derfang/FPGA-Board-with--400-IOs/README.md

> **Note:** Just read `FPGA_Project.pdf` and `FPGA project Report.pdf` for details.
