derfang/FPGA-Board-with--400-IOs/FPGA project Report.pdf

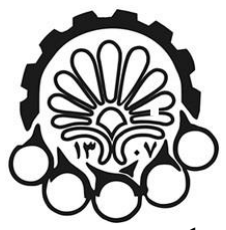
[picture p1: figure]

## دانشگاه صنعتي امیرکبیر

### )پلیتکنیک تهران( دانشكده مهندسی برق

# گزارش پروژه درس مدارهای منطقی برنامه پذیر

### دکتر شریعتمدار

## نگارش

### دانیال فتح پور 9923059

### عرفان قصری 9923061

زمستان 1402

# فهرست محتوا

# بخش اول:

# طراحی کلی مدار:

### سیستم را به طور کلی به دو بخش برد اصلی )برد دارای FPGA، Ethernet و قابلیت اتصال به برد های IO )و 10 عدد برد IO( قابلیت اتصال به 10 ورودی دیجیتال، 10 خروجی دیجیتال، 10 ورودی آنالوگ، 10 خروجی آنالوگ و 422RS )تقسیم می کنیم که بلوک دیاگرام آن ها به صورت زیر است:

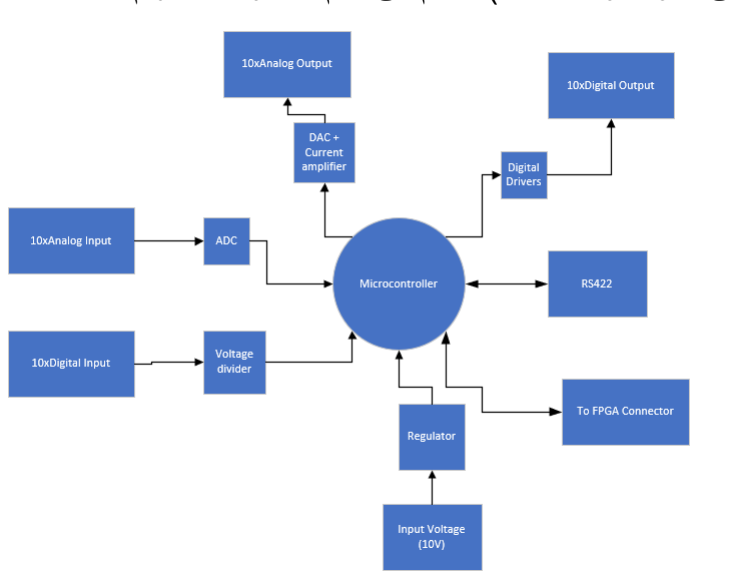
[picture p2: figure]
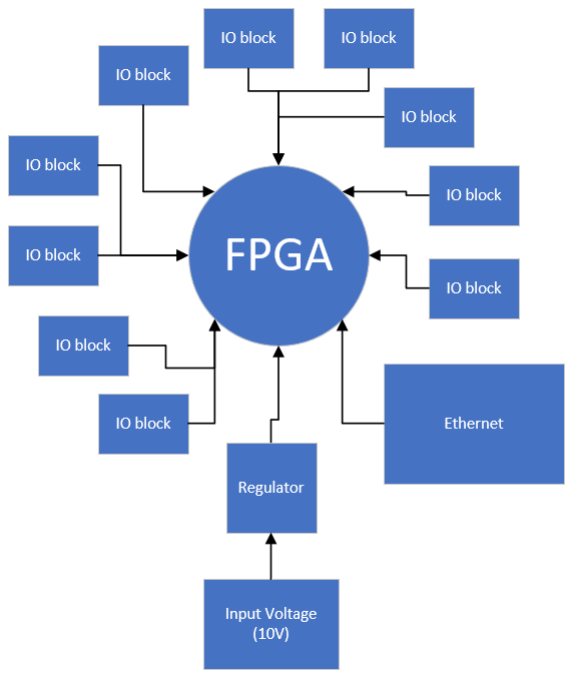
[picture p3: figure]

# انتخاب قطعات:

## انتخاب میکرو:

برای انتخاب میکرو مد نظر در هر Board IO بر اساس طرح کلی اولیه به برنامه cubeMX32STM مراجعه کرده و میکرو مد نظر را انتخاب می کنیم. در این جا میکرو 6RCT103F32STM انتخاب شد.در این جا خواسته ها عبارتند از: - 3 عدد SPI( یکی برای ارتباط با برد اصلی، یکی برای ADC و یکی برای DAC ) - تعداد مناسبی پین GPIO برای اتصال به بقیه قسمت ها

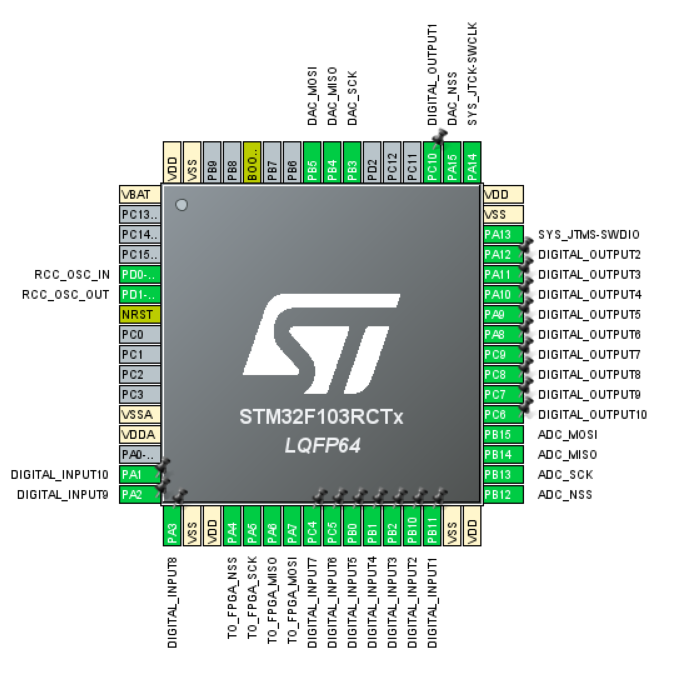
[picture p4: figure]

همانطور که مشخص است بر اساس طراحی اولیه باال تمامی خواسته های برد برطرف می شود.

## انتخاب تراشه ADC و DAC :

### ابتدا برای انتخاب تراشه ADC از طریق سایت شرکت Devices Analog اقدام می کنیم و و بر اساس نیاز های این برد تراشه 11311MAX را انتخاب می کنیم )حداقل 10 کانال داشته باشد و سطح ولتاژ 5± را تحمل کند .( که متوجه می شویم هم می تواند ADC و هم DAC باشد و جریان خروجی آن 25

میلی آمپر است که بنابراین نیاز است از تقویت کننده جریان )یک مدار پوش پول( استفاده کنیم.

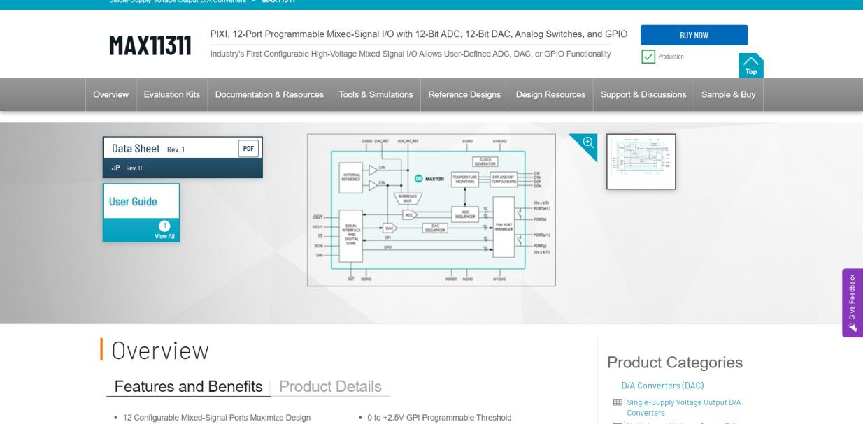
[picture p5: figure]

## انتخاب درایور دیجیتال:

برای اعمال ولتاژ های باالی 3.3ولت نیازمند درایور برای خروجی دیجیتال هستیم که ساده ترین آن ها یک ترانزیستور است که توان جریان دهی مناسبی داشته باشد و ابعاد کمی هم داشته باشد بر این اساس 817BC انتخاب می شود.

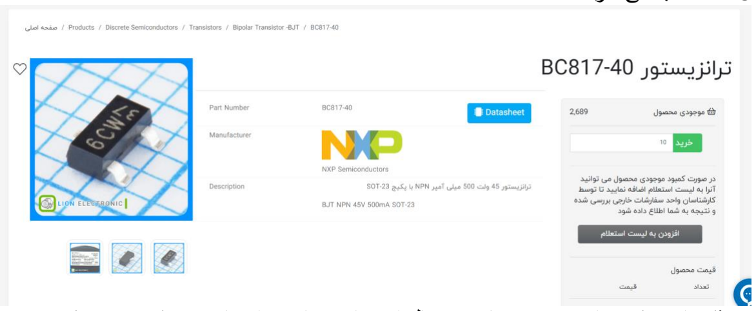
[picture p6: figure]

### الزم به ذکر است که برای ورودی های دیجیتال از تراشه خاصی استفاده نمی کنیم و به یک تقسیم

مقاومتی ساده بسنده می کنیم.

## انتخاب درایور 422RS:

### برای انتخاب این درایور از سایت instrument Texas کمک می گیریم و به تراشه 1400THVD می

رسیم.

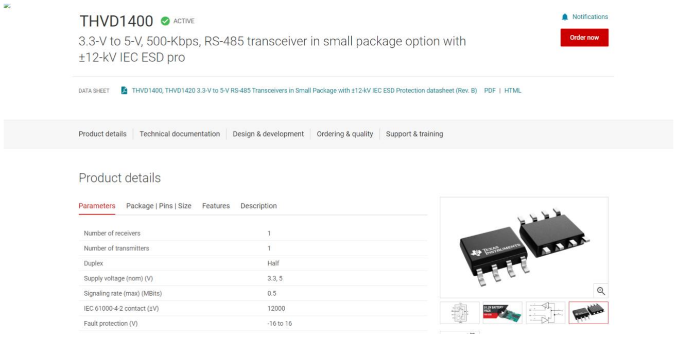
[picture p7: figure]

## انتخاب درایور Ethernet:

### برای انتخاب این تراشه از PCB اپن سورس OpenRex استفاده می کنیم و همان تراشه ای که در آنجا

استفاده شده را قرار می دهیم که تراشه RNXIA9031KSZ است.

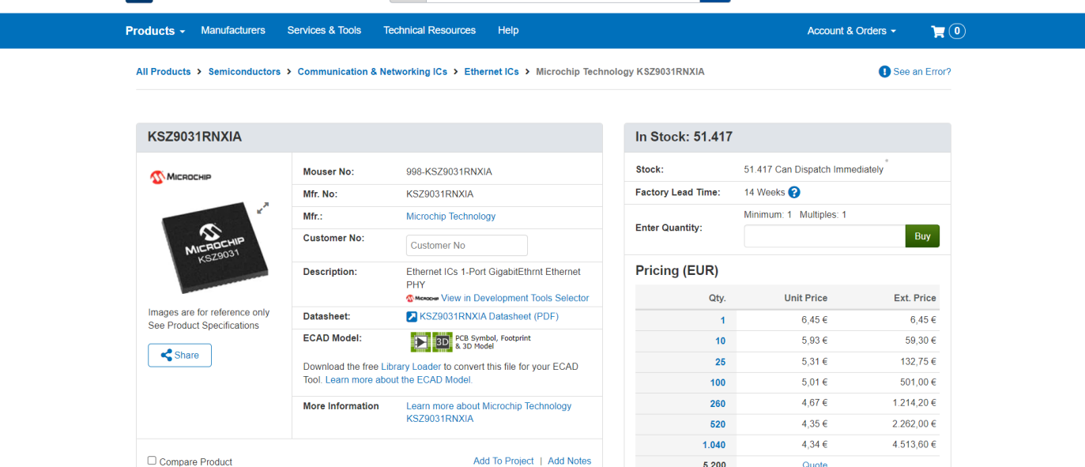
[picture p8: figure]

## انتخاب هسته اصلی:

برای انتخاب هسته اصلی از نرم افزار Vivado استفاده می کنیم و بر اساس خواسته های مسئله )10 عدد برد IO و یک عدد اترنت و 10 عدد ارتباط 422RS که در مجموع به حدود 100 عدد پایه نیازمندیم.( یک FPGA را انتخاب می کنیم. دلیل انتخاب تراشه FPGA به عنوان هسته اصلی سرعت آن و قابلیت موازی سازی آن است. نکته دیگر در مورد انتخاب FPGA ها این است که تا حد ممکن می

خواهیم از تراشه ای استفاده کنیم که برد آماده آن وجود داشته باشد تا بتوانیم مدار های جانبی تراشه

### مرکزی را به درستی طراحی کنیم. بنابر تمام نکات گفته شده به سری برد های PicoZed از شرکت

### Avnet می رسیم و برد 010Z7 را به دلیل اینکه 113 پایه IO دارد )خود تراشه دارای 225 پین است(

انتخاب می کنیم که دارای تراشه 225CLG010-1Z7XC است.

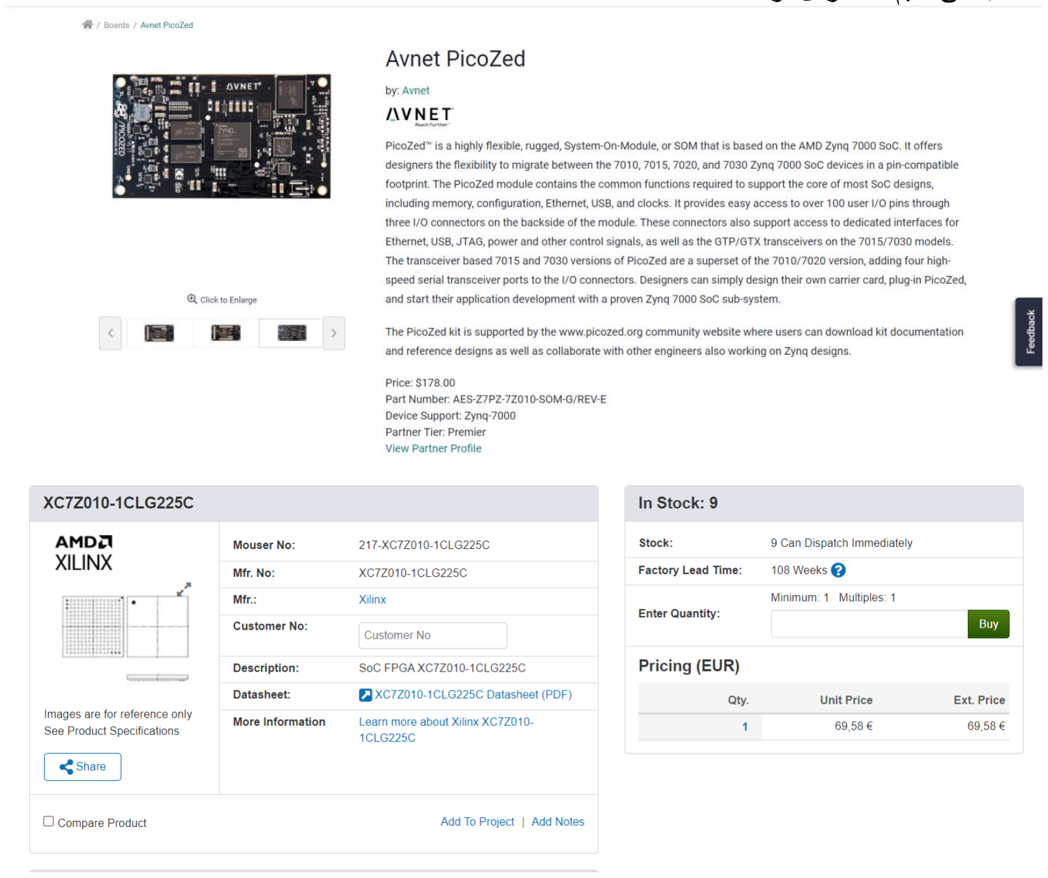
[picture p9: figure]

## انتخاب تغذیه:

بر اساس هسته اصلی، درایور اترنت، میکرو و تراشه آنالوگ به چند سطح ولتاژ DC نیازمندیم که برای

### هر کدام باید رگوالتور مربوطه را قرار دهیم. این تراشه رگوالتور ها را از سایت شرکت Texas instrument انتخاب می کنیم و در صورت توان از مدار های برد های اپن سورسی که در اختیار داریم

کمک می گیریم.
1V:

### TLV62130RGT

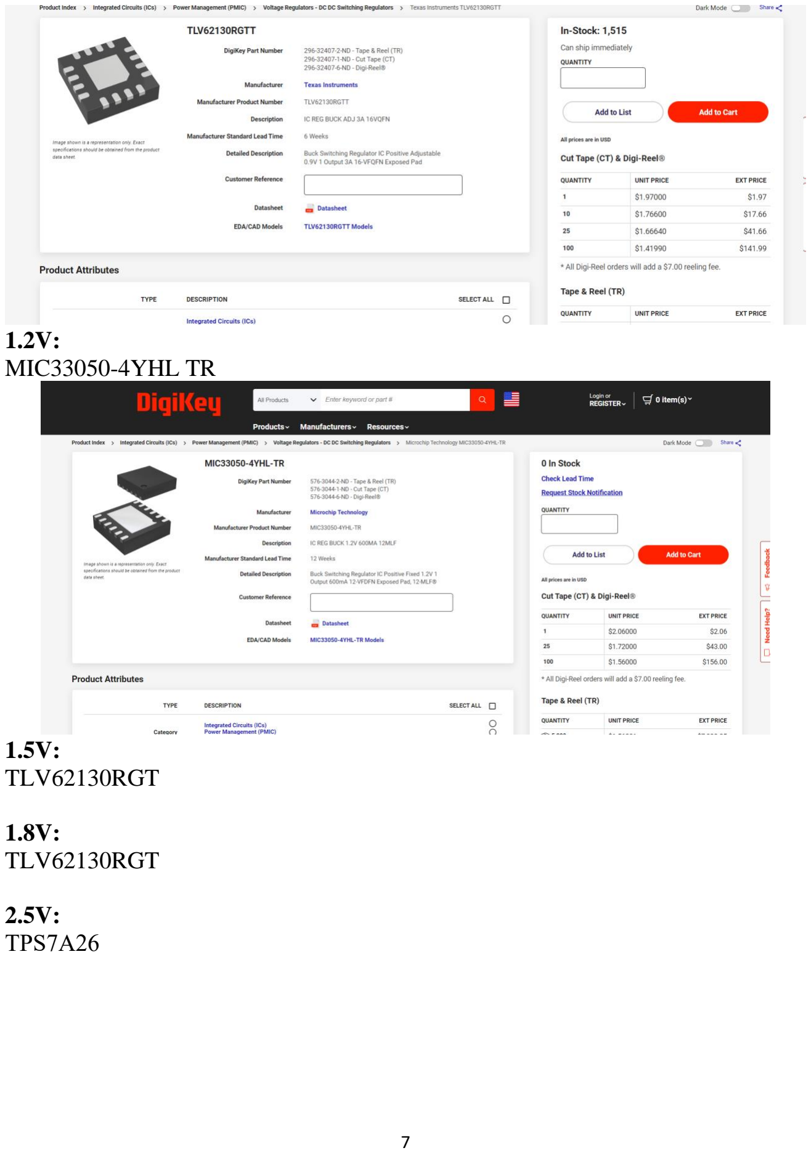
[picture p10: page 8]

1.2V:

### MIC33050-4YHL TR

1.5V:

### TLV62130RGT

1.8V:

### TLV62130RGT

2.5V:

### TPS7A26

3.3V:

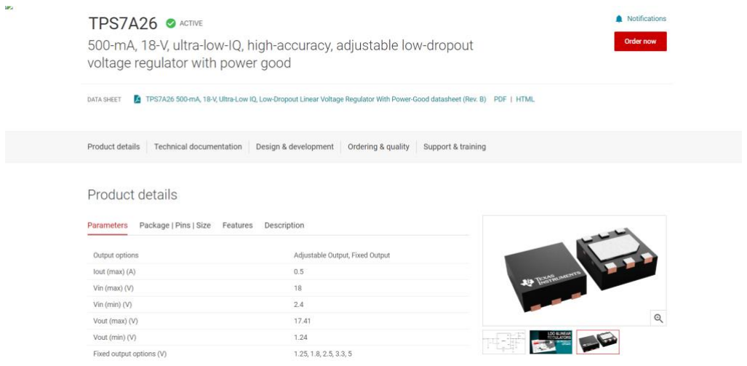
[picture p11: figure]

### ISL8024AIRTAJZ-T7A

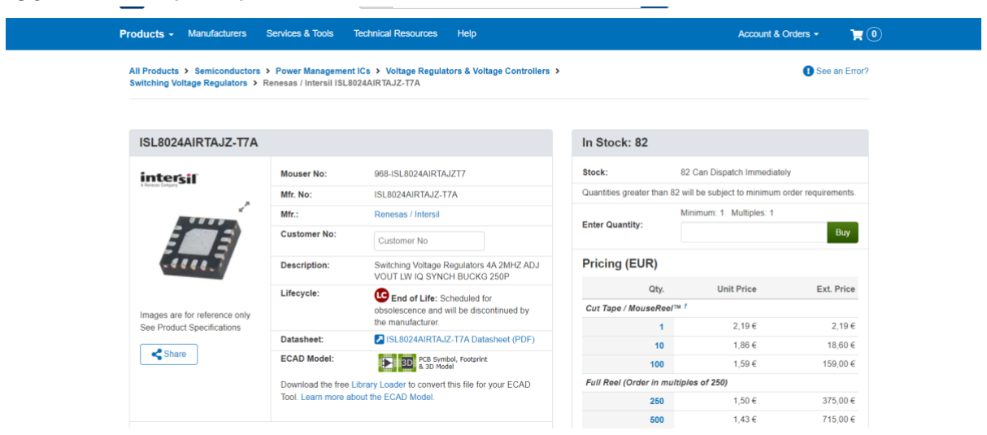
[picture p12: figure]

# ترسیم شماتیک:

## بخش توان:

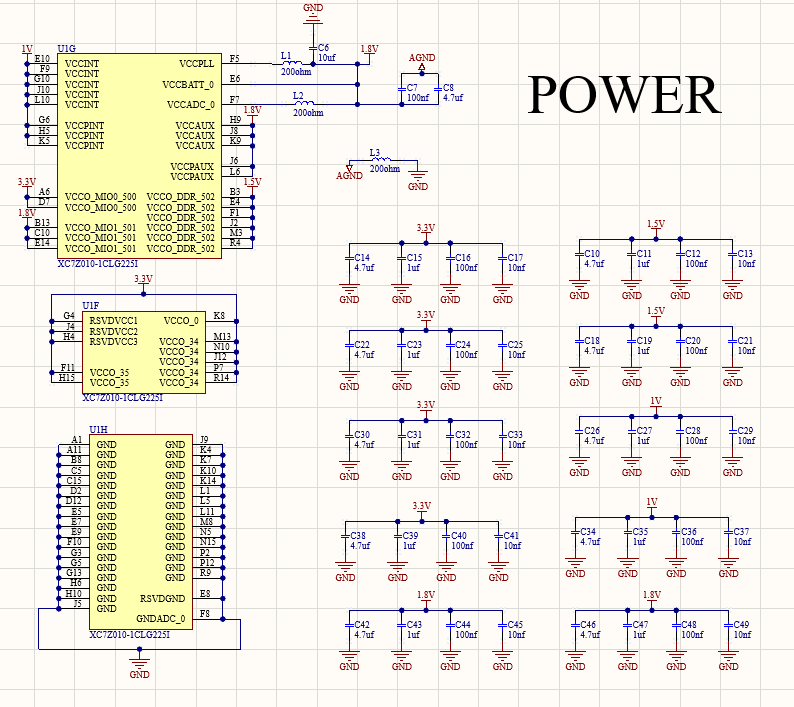
[picture p13: figure]

تصو یر شماره 1 : تامین توان تراشه اصلی

### در این بخش از نمونه های ارایه شده در فایل های تدریس یاری استفاده کردیم، خازن های با ظرفیت ها متفاوت برای حذف نویز در فرکانس های متفاوت به دلیل ض ریب کیفیت متفاوت خازن ها)ضرایب

کمتر برای خازن های بزرگ تر( به کار رفته اند.

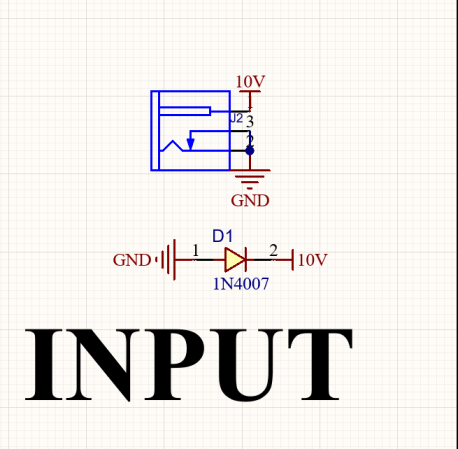
[picture p14: figure]

تصو یر شماره 2 : ورودی برق و دیود برای جلوگیری از آسیب دیدن مدار در صورت اتصال اشتباه قطب های مثبت و منفی

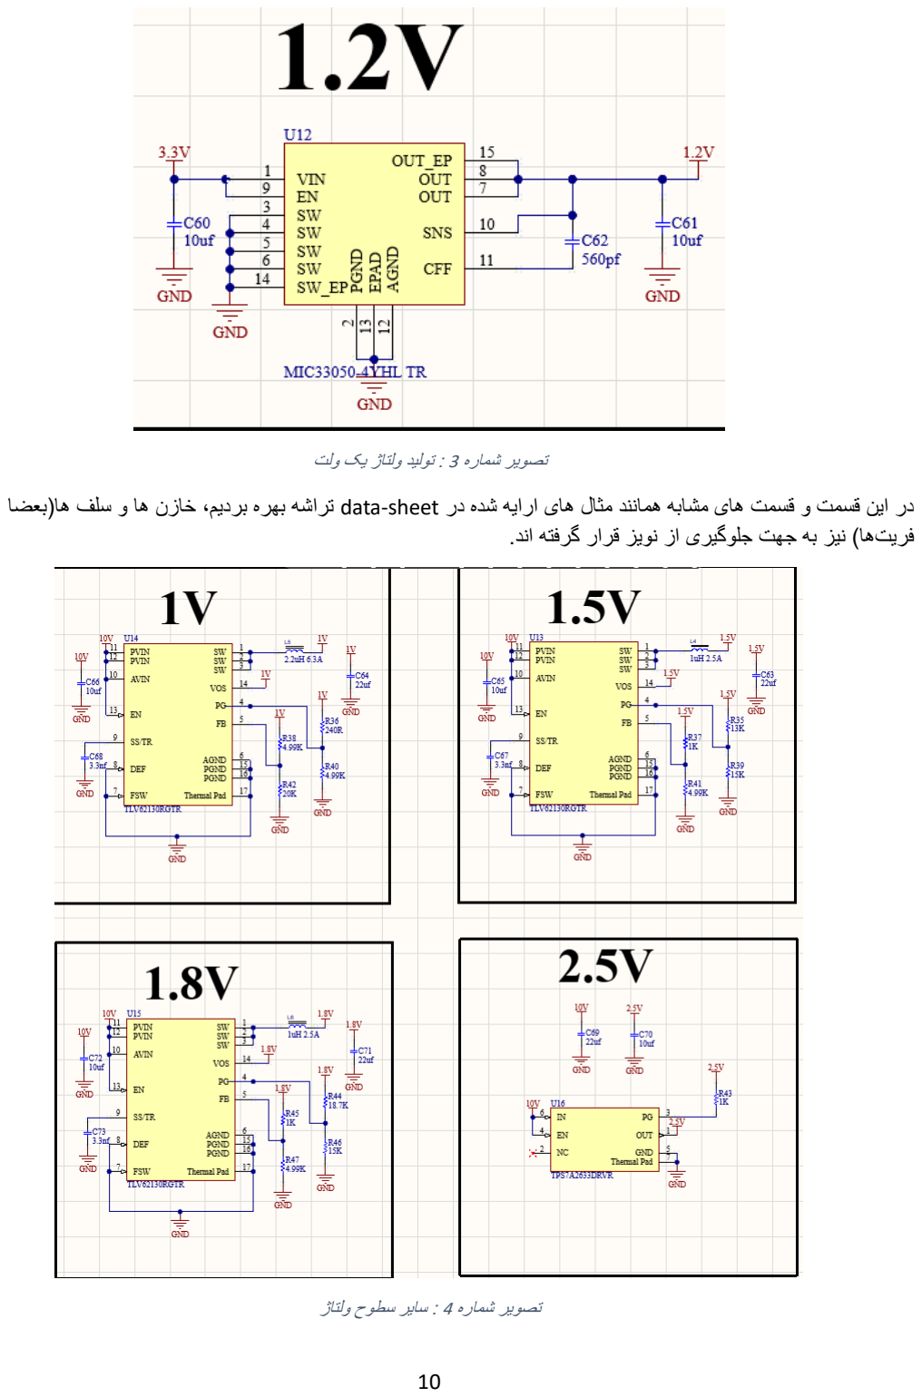
[picture p15: page 11]

تصو یر شماره 3 : تولید ولتاژ یک ولت

در این قسمت و قسمت های مشابه همانند مثال های ارایه شده در sheet-data تراشه بهره بردیم، خازن ها و سلف ها)ب عضا فریت ها( نیز به جهت جلوگیری از نویز قرار گرفته اند.

تصو یر شماره 4 : سایر سطوح ولتاژ

## بخش درایور ethernet:

برای پیکربندی درایور اترنت نی ز از مثال خود دیتاشیت استفاده کردیم و تنها پ ورت های دیتا را از یکطرف به تراشه و از طرف دیگر به پورت وصل کردیم:

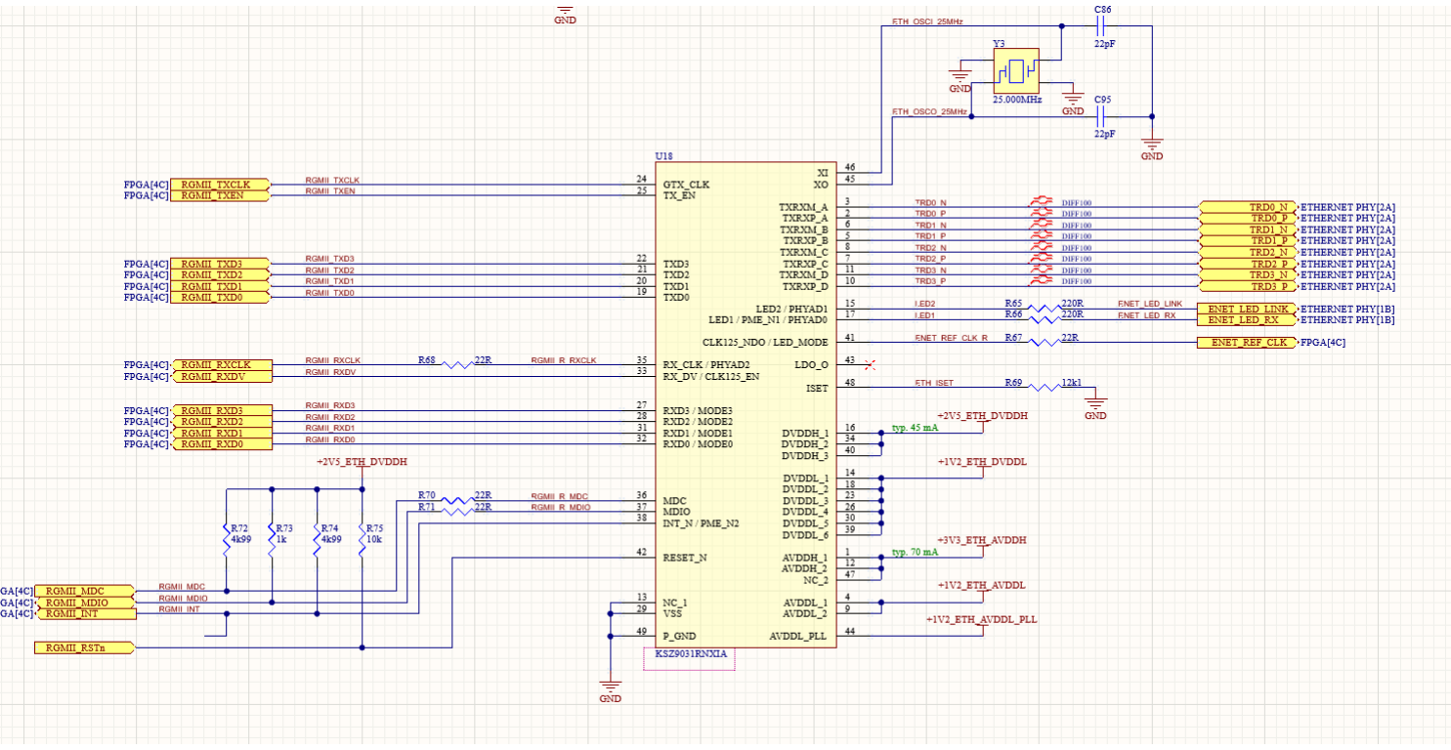
[picture p16: figure]

تصو یر شماره 5 : درایور اترنت به همراه نوسانگر مناسب

## بخش درایور 422RS:

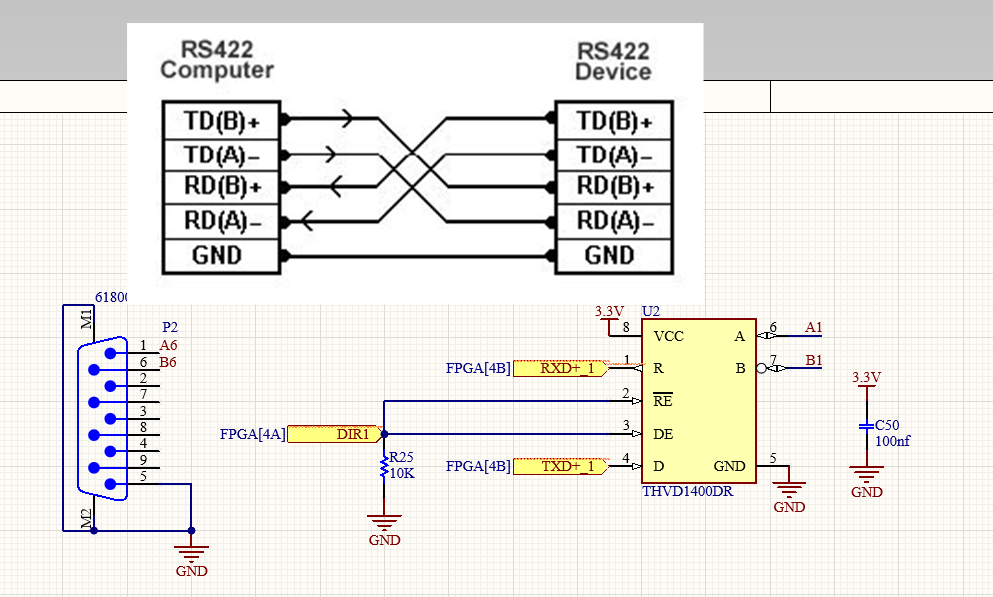
[picture p17: figure]

تصو یر شماره 6 : مجموعه درایور و پورت مادگی مناسب

## بخش راه انداز FPGA:

برای این بخ ش از یک حافظه کوچک استفاده کردیم:

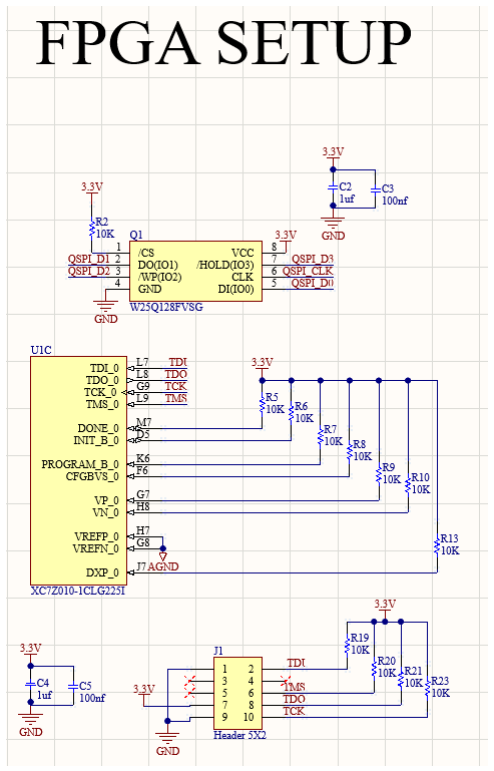
[picture p18: figure]

## بخش راه انداز FPGA:

به دلی ل شباهت بخش های مختلف تراشه اصلی تنها یک بخش از آنرا در تصویر زیر آوردم، برخی پورت ها از پیش تایین شده بودند که آنها را به مقادیر مناسبشان متصل کردیم، سایر پورت ها را با توجه به اطالعاتی که توسط Vivado درباره نوع پورت)برای مثال برخی پورت هاonly read بودند( تامین کرده بود به قسمت های مناسب)block-IO برای سیگنال های آنالوگ و دیجیتال که ب خش های ب عدی به آن میپردازم و درایور های 422RS و Ethernet به طور مستقیم( متصل کردیم.

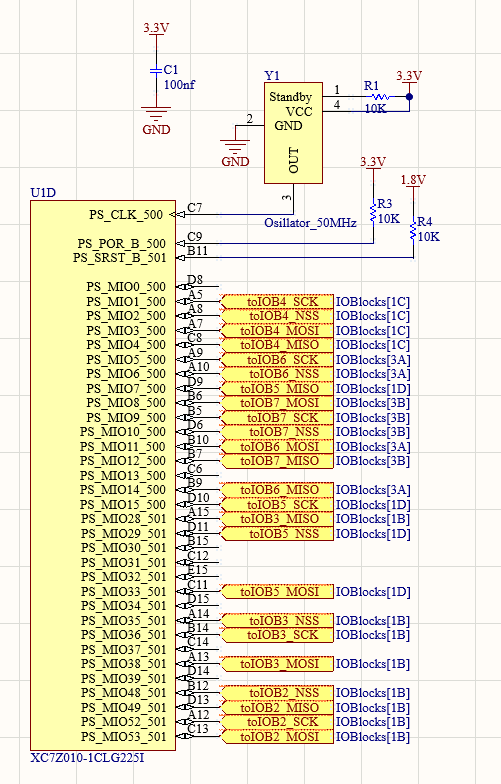
[picture p19: figure]

تصو یر شماره 7 : قسمتی از خود تراشه

## بخش های IO:

10 نمونه از بخش های IO را به برد اصلی وصل خواهیم کرد و هر برد IO بخش های زیر را دارد:

Power .1
.2 مبدل ولتاژ برای تامین ولتاژ مناسب میکرو:

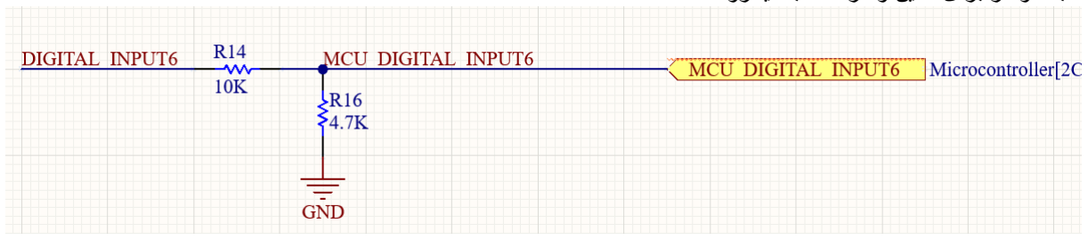
[picture p20: figure]
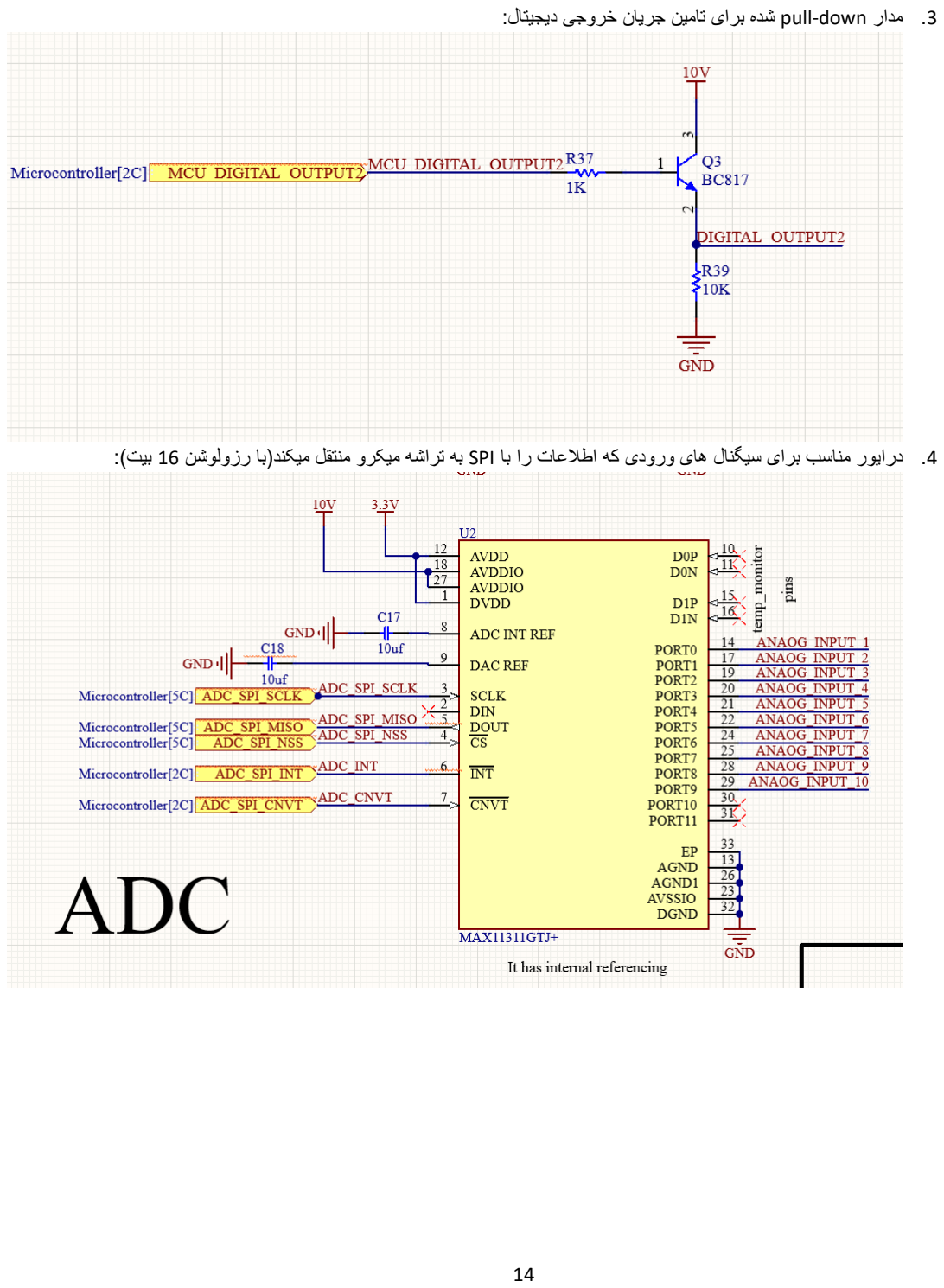
[picture p21: page 15]

.3 مدار down-pull شده برای تامین جریان خروجی دیجیتال:

.4 درایور مناسب برای سیگنال های ورودی که اطالعات را با SPI به تراشه میکرو من تقل میکند)با رزولوشن 16 بی ت(:

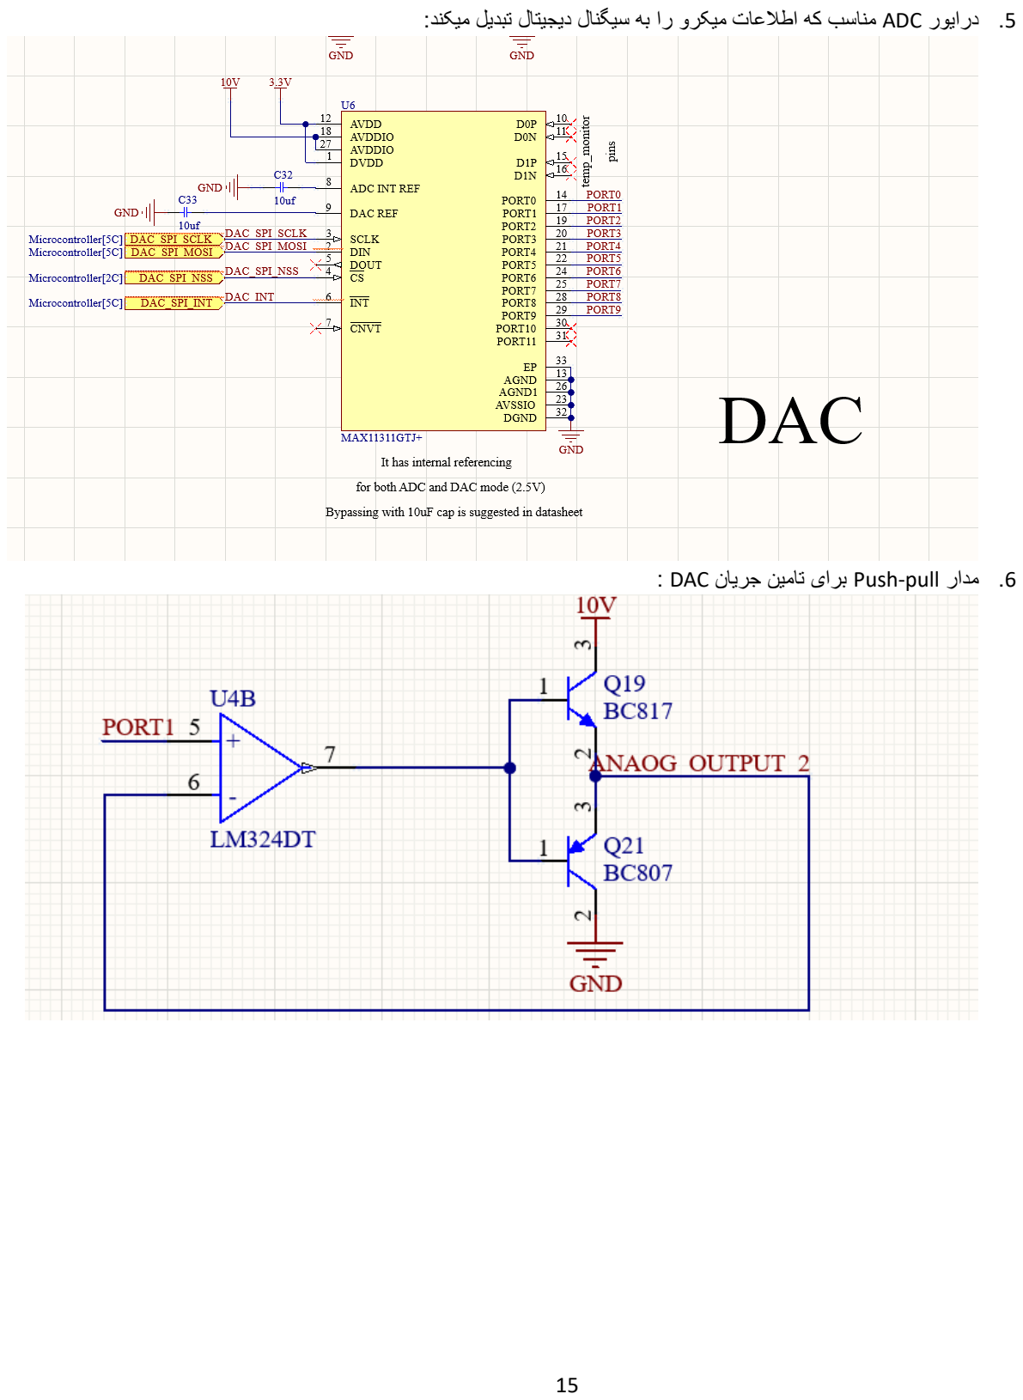
[picture p22: page 16]

.5 درایور ADC مناسب که اطالعات میکرو را به سیگنال دیجیتال تبدیل میکند:

.6 مدار pull-Push برای تامین جریان DAC :

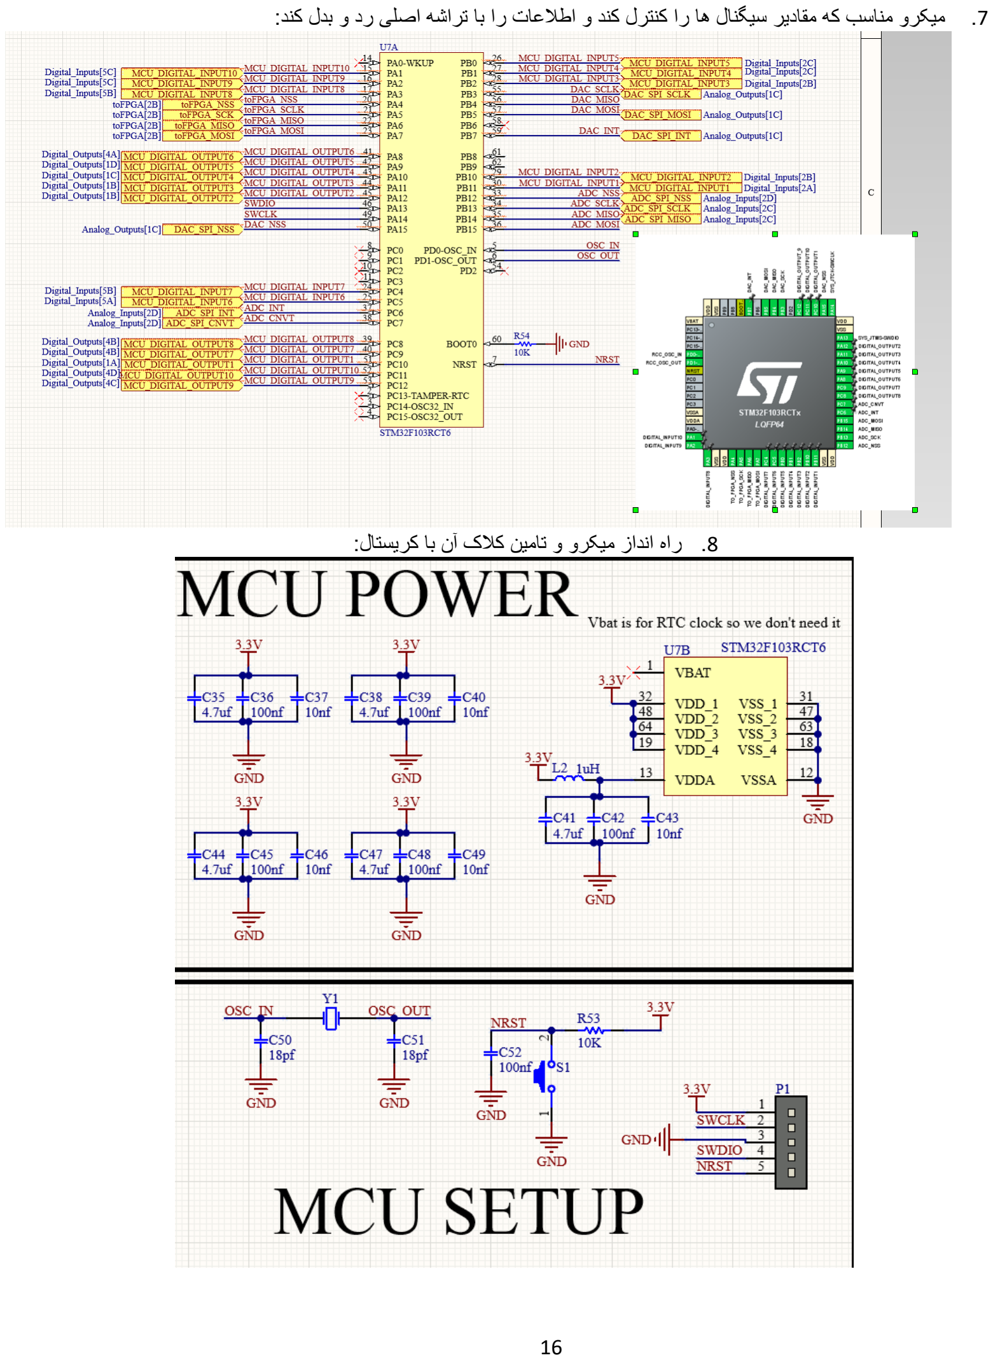
[picture p23: page 17]

.7 میکرو مناسب که مقادیر سیگنال ها را کنترل کند و اطالعات را با تراشه اصلی رد و بدل کند:

.8 راه انداز میکرو و تامین کالک آن با کریستال:

.9 یک کانکتور که اطالعات را به تراشه اصلی طبقSPI منتقل کند:

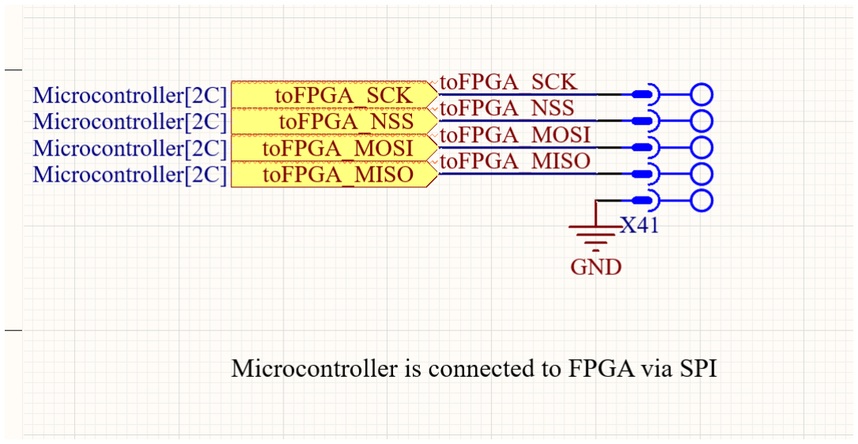
[picture p24: figure]

# بخش دوم:

این بخش عالر قم سنگین ترین بخش پروژه بودن توضیح خا صی ندارد و صرفا درد و رنج بود.

# بخش سوم

# تعریف پین ها:

در ابتدا TOP ماژول را طبق شکل زیر)صرفا پورت های از پیش رزور نشده( به ترتیب در قسمت پورت ماژول وارد میکنیم و سپش از طریق design elaborate به تخصیص پایه های مناسب میپردازیم:

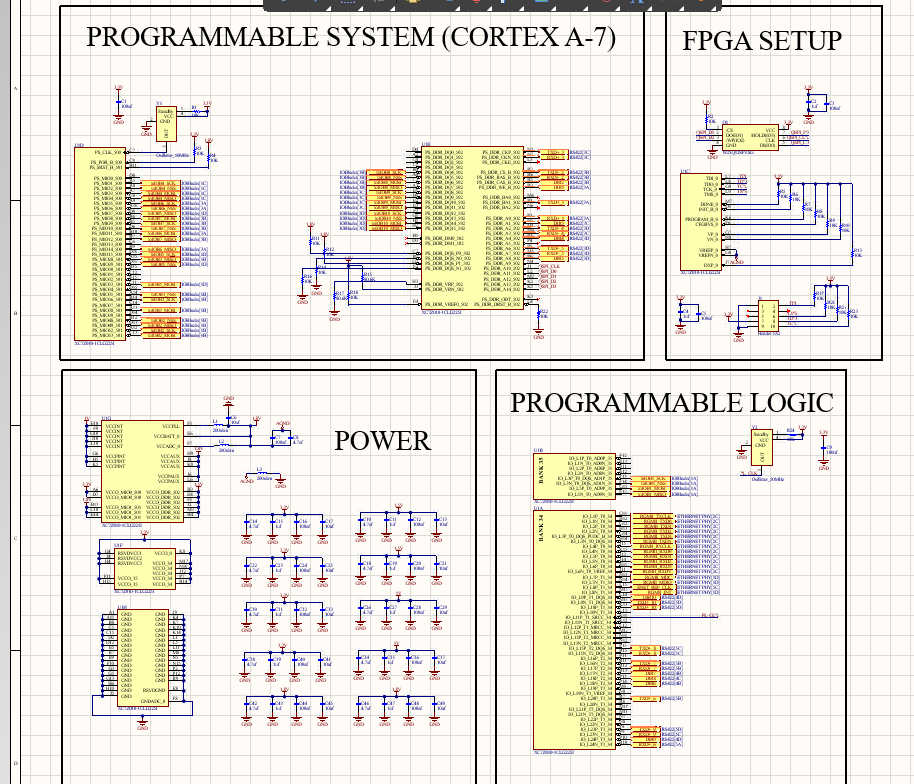
[picture p25: figure]

entity top is
port (
clk50MHz : in std_logic;
toIOB4_SCK : out std_logic; toIOB4_NSS : out std_logic; toIOB4_MOSI : out std_logic; toIOB4_MISO : in std_logic; toIOB6_SCK : out std_logic; toIOB6_NSS : out std_logic;

toIOB5_MISO : in std_logic; toIOB7_MOSI : out std_logic; toIOB7_SCK : out std_logic; toIOB7_NSS : out std_logic; toIOB6_MOSI : out std_logic; toIOB7_MISO : in std_logic; toIOB6_MISO : in std_logic; toIOB5_SCK : out std_logic; toIOB3_MISO : in std_logic; toIOB5_NSS : out std_logic; toIOB5_MOSI : out std_logic; toIOB3_NSS : out std_logic; toIOB3_SCK : out std_logic; toIOB3_MOSI : out std_logic; toIOB2_NSS : out std_logic; toIOB2_MISO : in std_logic; toIOB2_SCK : out std_logic; toIOB2_MOSI : out std_logic; toIOB8_SCK : out std_logic; toIOB8_NSS : out std_logic; toIOB8_MOSI : out std_logic; toIOB8_MISO : in std_logic; toIOB9_SCK : out std_logic; toIOB9_NSS : out std_logic; toIOB9_MOSI : out std_logic; toIOB9_MISO : in std_logic; toIOB10_SCK : out std_logic; toIOB10_NSS : out std_logic; toIOB10_MOSI : out std_logic; toIOB10_MISO : in std_logic; TXD3 : out std_logic;
RXD3 : in std_logic;
TXD2 : out std_logic;
RXD2 : in std_logic;
DIR2 : out std_logic;
DIR1 : out std_logic;
TXD1 : out std_logic;
RXD1 : in std_logic;
DIR3 : out std_logic;
TXD4 : out std_logic;
RXD4 : in std_logic;
DIR4 : out std_logic;
TXD5 : out std_logic;
RXD5 : in std_logic;
DIR5 : out std_logic;

QSPI_CLK : out std_logic;
QSPI_D0 : inout std_logic; QSPI_D1 : inout std_logic; QSPI_D2 : inout std_logic; QSPI_D3 : inout std_logic; TDI : in std_logic;
TDO : out std_logic;
TCK : in std_logic;
TMS : in std_logic;
toIOB1_SCK : out std_logic; toIOB1_NSS : out std_logic; toIOB1_MOSI : out std_logic; toIOB1_MISO : in std_logic; RGMII_TXCLK : out std_logic; RGMII_TXD0 : out std_logic; RGMII_TXD1 : out std_logic; RGMII_TXD2 : out std_logic; RGMII_TXD3 : out std_logic; RGMII_TXEN : out std_logic; RGMII_RXCLK : in std_logic; RGMII_RXD0 : in std_logic; RGMII_RXD1 : in std_logic; RGMII_RXD2 : in std_logic; RGMII_RXD3 : in std_logic; RGMII_RXDV : in std_logic; RGMII_MDC : out std_logic; RGMII_MDIO : inout std_logic; ENET_REF_CLK : in std_logic; RGMII_INT : in std_logic;
DIR10 : out std_logic;
TXD10 : out std_logic;
RXD10 : in std_logic;
PL_CLK : out std_logic;
TXD8 : out std_logic;
RXD8 : in std_logic;
TXD7 : out std_logic;
RXD7 : in std_logic;
DIR7 : out std_logic;
DIR8 : out std_logic;
DIR6 : out std_logic;
TXD6 : out std_logic;
TXD9 : out std_logic;
RXD9 : in std_logic;
DIR9 : out std_logic;
RXD6 : in std_logic

);
end entity top;
پایه ها طبق تصویر و از باال به پایین و از چ پ به راست ان تخاب شده اند

کانترین تولید شده:

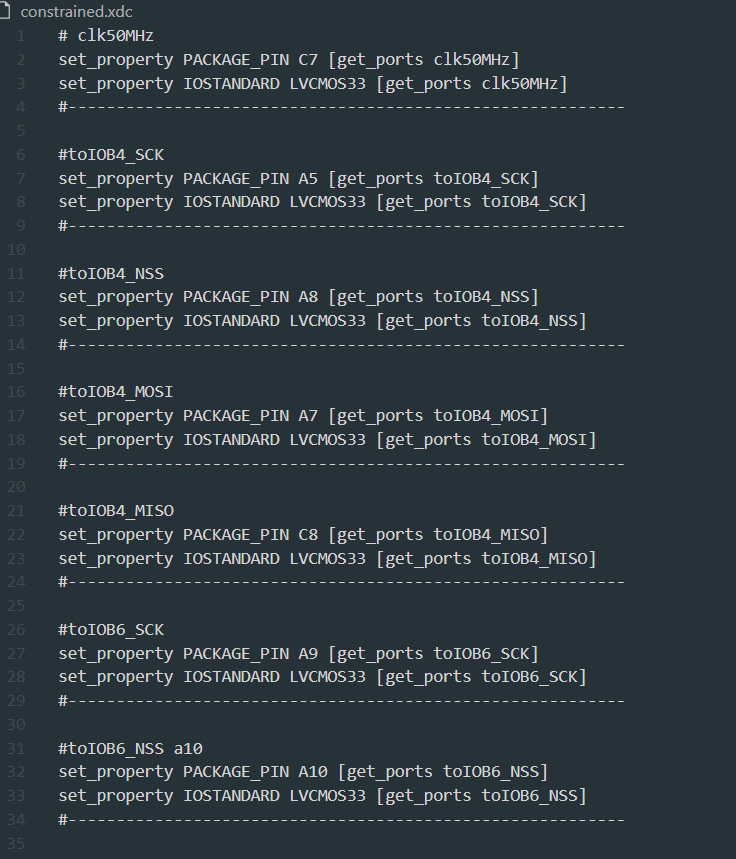
[picture p26: figure]

# کدنویسی 422RS:

## برای این طراحی با توجه به اینکه ساخت سیگنال تفاضلی در قسمت درایور انجام میشود، ما تنها با سیگنال های ارسالی )10 جفت RX و TX به همراه سیگنال های کنترل داده CTS و RTS )سر و کار داریم، همچنین اطالعات را در قالب پکت های 8 بیتی)به همراه یک بیت شروع و یک بیت پایان، یعنی در مجموع 10 بیت ارسال میکنیم(

## کار نسبتا ساده است، سیگنال داده ورودی را)که توسط خود تراشه تامین میشود( را به 8 قسمت میشکنیم و در هر کالک یکی از این قسمت ها را بر روی 10 پورت TX سوار

میکنیم تا ارسال شوند.
در شروع داده های پایلوت 0 و در پایان ارسال نیز پایلوت 1 ارسال میشود. برای اطالعات دریافتی نیز دقیقا برعکس این عمل را انجام میدهیم.

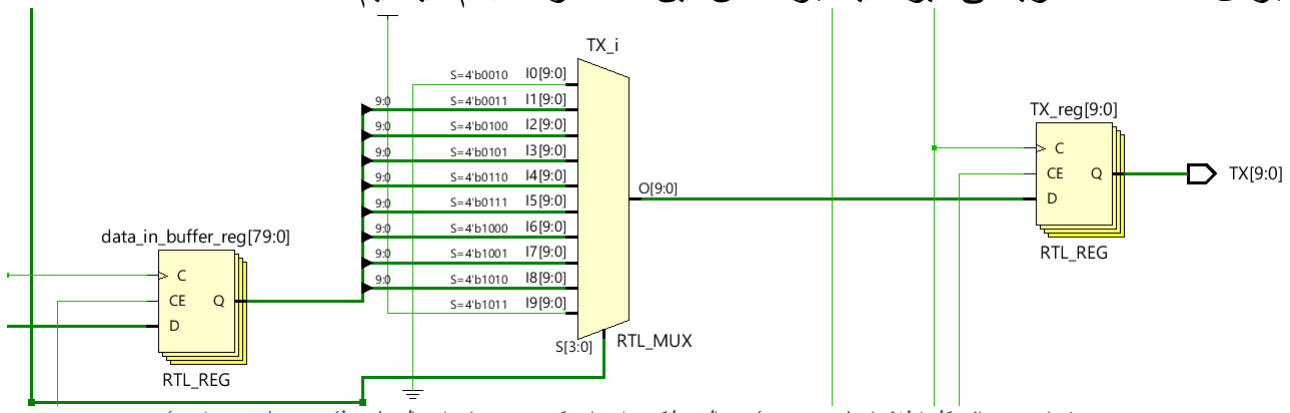
[picture p27: figure]

تصو یر شماره :8 بافر کل اطالعات)سیمت چپ( و مالتی پلکسر انتخاب کننده بیت های ارسالی )وسط( و TX( سمت راست(

entity RS422 is
port(
clk : in std_logic;
data_in : in std_logic_vector(79 downto 0); -- 10 bytes of data data_out : out std_logic_vector(79 downto 0); -- 10 bytes of data RTS : out std_logic := '0';
CTS : in std_logic := '0';
TX : out std_logic_vector(9 downto 0);
RX : in std_logic_vector(9 downto 0); send : in std_logic;
ready : out std_logic
);

end RS422;

## تجزیه ورودی و ترکیب RX به همراه ساخت مجموعه حالت ها

type state_type is (idle, request_to_send, sending_start_bit, send_0, send_1, send_2, send_3, send_4, send_5, send_6, send_7, send_stop_bit);
signal state : state_type := idle;
begin
data_in_buffer0 <= data_in_buffer(9 downto 0); data_in_buffer1 <= data_in_buffer(19 downto 10); data_in_buffer2 <= data_in_buffer(29 downto 20); data_in_buffer3 <= data_in_buffer(39 downto 30); data_in_buffer4 <= data_in_buffer(49 downto 40); data_in_buffer5 <= data_in_buffer(59 downto 50); data_in_buffer6 <= data_in_buffer(69 downto 60); data_in_buffer7 <= data_in_buffer(79 downto 70);

data_out_buffer(9 downto 0) <= data_out_buffer0; data_out_buffer(19 downto 10) <= data_out_buffer1; data_out_buffer(29 downto 20) <= data_out_buffer2; data_out_buffer(39 downto 30) <= data_out_buffer3; data_out_buffer(49 downto 40) <= data_out_buffer4; data_out_buffer(59 downto 50) <= data_out_buffer5; data_out_buffer(69 downto 60) <= data_out_buffer6; data_out_buffer(79 downto 70) <= data_out_buffer7;

## سویچ بین حالت ها و ارسال اطالعات مناسب:

if rising_edge(clk) then
case state is
when idle =>
if send = '1' then
data_in_buffer <= data_in; ready <= '0';
state <= request_to_send;
end if;
when request_to_send =>
RTS <= '1';
if CTS = '1' then
RTS <= '0';
state <= sending_start_bit; end if;
when sending_start_bit =>
TX <= "0000000000";
state <= send_0;
when send_0 =>
TX <= data_in_buffer0;
state <= send_1;
when send_1 =>
TX <= data_in_buffer1;
state <= send_2;

-----------------------حالت های دیگر صرف نظر شده ولی در سورس موجودند-------------------------------------when send_7 =>
TX <= data_in_buffer7;
state <= send_stop_bit;
when send_stop_bit =>
TX <= "1111111111";
ready <= '1';
state <= idle;
end case;
end if;

دریافت اطالعات نیز به همین صورت میباشد.

## در نهایت برای تست کردن قطعات 1 نمونه از 422RS را میسازیم و ورودی یکی را به خروجی دیگری متصل میکنیم و انتظار داریم تا دیتای ورودی هر یک در خروجی دیگری

ظاهر شود.

uut1: RS422 port map (
clk => clk,
data_in => data_in1,
data_out => data_out1,
RTS => RTS,
CTS => CTS,
TX => TX1,
RX => RX1,
send => send,
ready => ready
);

uut2: RS422 port map (
clk => clk,
data_in => data_in2,
data_out => data_out2,
RTS => RTS,
CTS => CTS,
TX => TX2,
RX => RX2,
send => send,
ready => ready
);

RX1 <= TX2;
RX2 <= TX1;

## کالک را برای مثال 1 مگ در نظر گرفتم ولی در واقعیت این مقدار بسیار پایین تر و در

حدود چند صد کیلوبایت است.

clk_gen(clk, 1.0e6, 50.0); -- 100 MHz clock with 50% duty cycle is T = 1 us

stim_proc: process
begin
-- hold reset state for 100 ns. wait for 1 us;

-- insert stimulus here
-- data_in1 <= x"FAFAFAFAFAFAFAFAFAFA"; -- data_in2 <= x"5A5A5A5A5A5A5A5A5A5A"; data_in1 <= x"00000000000000000000"; data_in2 <= x"FFFFFFFFFFFFFFFFFFFF"; wait for 1 us;

دستور ارسال برای هر دو نمونه ارسال میشود ;'1' => send wait for 1 us;
با یک شدن این سیگنال اجازه ارسال صادر میشود ;'1' => CTS send <= '0';
wait;
end process;

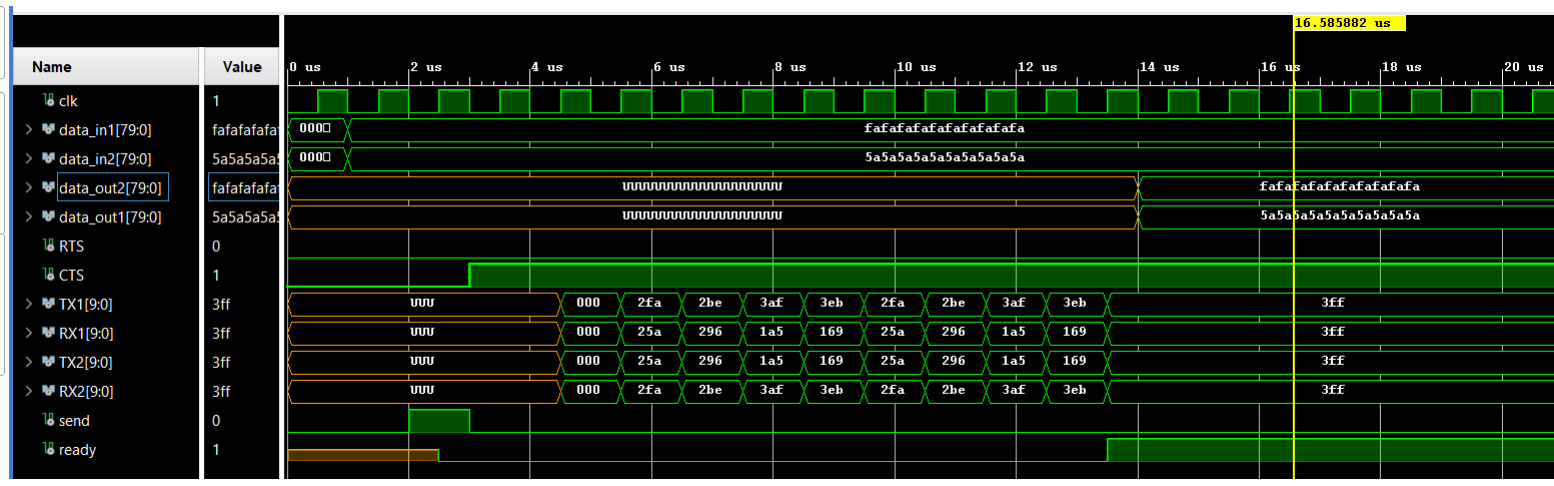
[picture p28: figure]

# میبینیم که طبق انتظار دیتای ورودی 1 در خروجی 2 و همچنین ورودی

2 در خروجی 1 ظاهر شد پس طرح به درستی کار میکند.

### باند ریت در این مثال s/Mbit1 است ولی برای بورد با توجه به محدود بودن نرخ ارسال و دریافت

درایور انتخابی به نیم مگابیت بر ثانیه، باند ریت s/kbit500 محدود میشود. البته این در حالت ایده آل بوده چرا که عواملی مانند طول کابل نیز میتوانند بر این مقدار تاثیر گذاشته و آنرا بازهم بکاهند.

### )در نظر داشتیم که ماژولیشنی بر روی اطالعات توسط درایور صورت نمیپذیرد یعنی

### )bit/symbol = 1
