derfang/FPGA-Board-with--400-IOs/(list of files, drawings)

Other design files:
FPGA_Board (2)/BlockDiagram.SchDoc
FPGA_Board (2)/ETHERNET PHY.SchDoc
FPGA_Board (2)/FPGA.SchDoc
FPGA_Board (2)/FPGA_Board.PrjPcb
FPGA_Board (2)/FPGA_Board.SchDoc
FPGA_Board (2)/IOBlocks.SchDoc
FPGA_Board (2)/Power.SchDoc
FPGA_Board (2)/RS422.SchDoc
IO_Board/Analog_Inputs.SchDoc
IO_Board/Analog_Outputs.SchDoc
IO_Board/BlockDiagram.SchDoc
IO_Board/Digital_Inputs.SchDoc
IO_Board/Digital_Outputs.SchDoc
IO_Board/IO_Board.PrjPcb
IO_Board/IO_Board.SchDoc
IO_Board/Microcontroller.SchDoc
IO_Board/Power.SchDoc
IO_Board/toFPGA.SchDoc
