derfang/FPGA-Board-with--400-IOs/IO_Board/IO_Board.ioc

Mcu.UserName=STM32F103RCTx
PA1.GPIO_Label=DIGITAL_INPUT10
PA1.Signal=GPIO_Input
PA10.GPIO_Label=DIGITAL_OUTPUT4
PA10.Signal=GPIO_Output
PA11.GPIO_Label=DIGITAL_OUTPUT3
PA11.Signal=GPIO_Output
PA12.GPIO_Label=DIGITAL_OUTPUT2
PA12.Signal=GPIO_Output
PA13.Signal=SYS_JTMS-SWDIO
PA14.Signal=SYS_JTCK-SWCLK
PA15.GPIO_Label=DAC_NSS
PA15.Signal=SPI3_NSS
PA2.GPIO_Label=DIGITAL_INPUT9
PA2.Signal=GPIO_Input
PA3.GPIO_Label=DIGITAL_INPUT8
PA3.Signal=GPIO_Input
PA4.GPIO_Label=TO_FPGA_NSS
PA4.Signal=SPI1_NSS
PA5.GPIO_Label=TO_FPGA_SCK
PA5.Signal=SPI1_SCK
PA6.GPIO_Label=TO_FPGA_MISO
PA6.Signal=SPI1_MISO
PA7.GPIO_Label=TO_FPGA_MOSI
PA7.Signal=SPI1_MOSI
PA8.GPIO_Label=DIGITAL_OUTPUT6
PA8.Signal=GPIO_Output
PA9.GPIO_Label=DIGITAL_OUTPUT5
PA9.Signal=GPIO_Output
PB0.GPIO_Label=DIGITAL_INPUT5
PB0.Signal=GPIO_Input
PB1.GPIO_Label=DIGITAL_INPUT4
PB1.Signal=GPIO_Input
PB10.GPIO_Label=DIGITAL_INPUT2
PB10.Signal=GPIO_Input
PB11.GPIO_Label=DIGITAL_INPUT1
PB11.Signal=GPIO_Input
PB12.GPIO_Label=ADC_NSS
PB12.Signal=SPI2_NSS
PB13.GPIO_Label=ADC_SCK
PB13.Signal=SPI2_SCK
PB14.GPIO_Label=ADC_MISO
PB14.Signal=SPI2_MISO
PB15.GPIO_Label=ADC_MOSI
PB15.Signal=SPI2_MOSI
PB2.GPIO_Label=DIGITAL_INPUT3
PB2.Signal=GPIO_Input
PB3.GPIO_Label=DAC_SCK
PB3.Signal=SPI3_SCK
PB4.GPIO_Label=DAC_MISO
PB4.Signal=SPI3_MISO
PB5.GPIO_Label=DAC_MOSI
PB5.Signal=SPI3_MOSI
PB7.GPIO_Label=DAC_INT
PB7.Signal=GPXTI7
PC10.GPIO_Label=DIGITAL_OUTPUT1
PC10.Signal=GPIO_Output
PC11.GPIO_Label=DIGITAL_OUTPUT10
PC11.Signal=GPIO_Output
PC12.GPIO_Label=DIGITAL_OUTPUT_9
PC12.Signal=GPIO_Output
PC4.GPIO_Label=DIGITAL_INPUT7
PC4.Signal=GPIO_Input
PC5.GPIO_Label=DIGITAL_INPUT6
PC5.Signal=GPIO_Input
PC6.GPIO_Label=ADC_INT
PC6.Signal=GPXTI6
PC7.GPIO_Label=ADC_CNVT
PC7.Signal=GPIO_Output
PC8.GPIO_Label=DIGITAL_OUTPUT8
PC8.Signal=GPIO_Output
PC9.GPIO_Label=DIGITAL_OUTPUT7
PC9.Signal=GPIO_Output
PD0-OSC_IN.Signal=RCC_OSC_IN
PD1-OSC_OUT.Signal=RCC_OSC_OUT
