derfang/FPGA-Board-with--400-IOs/code/constrained.xdc

# clk50MHz
set_property PACKAGE_PIN C7 [get_ports clk50MHz]
set_property IOSTANDARD LVCMOS33 [get_ports clk50MHz]
#----------------------------------------------------------

#toIOB4_SCK
set_property PACKAGE_PIN A5 [get_ports toIOB4_SCK]
set_property IOSTANDARD LVCMOS33 [get_ports toIOB4_SCK]
#----------------------------------------------------------

#toIOB4_NSS
set_property PACKAGE_PIN A8 [get_ports toIOB4_NSS]
set_property IOSTANDARD LVCMOS33 [get_ports toIOB4_NSS]
#----------------------------------------------------------

#toIOB4_MOSI
set_property PACKAGE_PIN A7 [get_ports toIOB4_MOSI]
set_property IOSTANDARD LVCMOS33 [get_ports toIOB4_MOSI]
#----------------------------------------------------------

#toIOB4_MISO
set_property PACKAGE_PIN C8 [get_ports toIOB4_MISO]
set_property IOSTANDARD LVCMOS33 [get_ports toIOB4_MISO]
#----------------------------------------------------------

#toIOB6_SCK
set_property PACKAGE_PIN A9 [get_ports toIOB6_SCK]
set_property IOSTANDARD LVCMOS33 [get_ports toIOB6_SCK]
#----------------------------------------------------------

#toIOB6_NSS a10
set_property PACKAGE_PIN A10 [get_ports toIOB6_NSS]
set_property IOSTANDARD LVCMOS33 [get_ports toIOB6_NSS]
#----------------------------------------------------------

#toIOB5_MISO d9
set_property PACKAGE_PIN D9 [get_ports toIOB5_MISO]
set_property IOSTANDARD LVCMOS33 [get_ports toIOB5_MISO]
#----------------------------------------------------------

#toIOB5_MISO b6
set_property PACKAGE_PIN B6 [get_ports toIOB5_MISO]
set_property IOSTANDARD LVCMOS33 [get_ports toIOB5_MISO]
#----------------------------------------------------------

#toIOB5_MISO b5
set_property PACKAGE_PIN B5 [get_ports toIOB5_MISO]
set_property IOSTANDARD LVCMOS33 [get_ports toIOB5_MISO]
#----------------------------------------------------------

#toIOB7_NSS d6
set_property PACKAGE_PIN D6 [get_ports toIOB7_NSS]
set_property IOSTANDARD LVCMOS33 [get_ports toIOB7_NSS]
#----------------------------------------------------------

#toIOB6_MOSI b10
set_property PACKAGE_PIN B10 [get_ports toIOB6_MOSI]
set_property IOSTANDARD LVCMOS33 [get_ports toIOB6_MOSI]
#----------------------------------------------------------

#toIOB7_MISO b7
set_property PACKAGE_PIN B7 [get_ports toIOB7_MISO]
set_property IOSTANDARD LVCMOS33 [get_ports toIOB7_MISO]
#----------------------------------------------------------

#toIOB6_MISO b9
set_property PACKAGE_PIN B9 [get_ports toIOB6_MISO]
set_property IOSTANDARD LVCMOS33 [get_ports toIOB6_MISO]
#----------------------------------------------------------

#toIOB5_SCK D10
set_property PACKAGE_PIN D10 [get_ports toIOB5_SCK]
set_property IOSTANDARD LVCMOS33 [get_ports toIOB5_SCK]
#----------------------------------------------------------

#toIOB3_MISO A15
set_property PACKAGE_PIN A15 [get_ports toIOB3_MISO]
set_property IOSTANDARD LVCMOS33 [get_ports toIOB3_MISO]
#----------------------------------------------------------

#toIOB5_NSS d11
set_property PACKAGE_PIN D11 [get_ports toIOB5_NSS]
set_property IOSTANDARD LVCMOS33 [get_ports toIOB5_NSS]
#----------------------------------------------------------

#toIOB5_MOSI c11
set_property PACKAGE_PIN C11 [get_ports toIOB5_MOSI]
set_property IOSTANDARD LVCMOS33 [get_ports toIOB5_MOSI]
#----------------------------------------------------------

#toIOB3_NSS A14
set_property PACKAGE_PIN A14 [get_ports toIOB3_NSS]
set_property IOSTANDARD LVCMOS33 [get_ports toIOB3_NSS]
#----------------------------------------------------------
